PascalMALLE/ESP32-C3-IoT-Board/3DBoards view from DFM.png

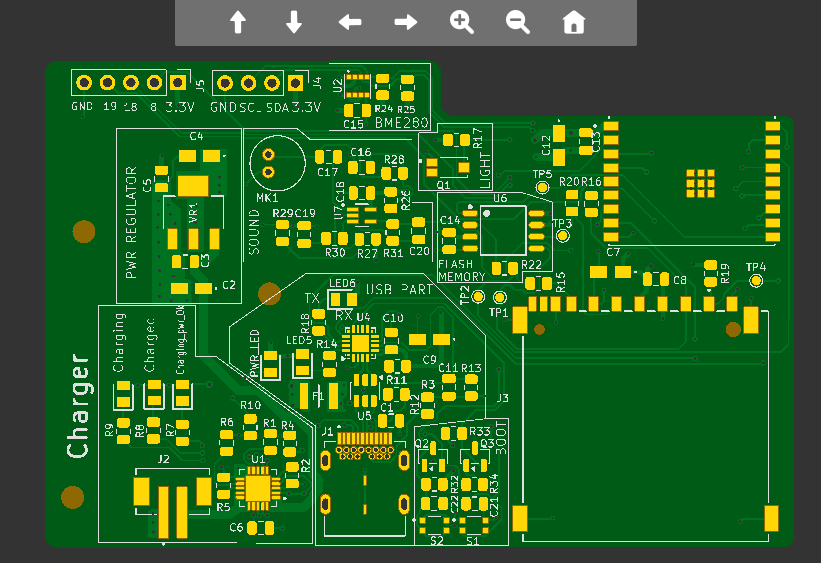
3DBoards view from DFM.png
