PascalMALLE/ESP32-C3-IoT-Board/3DBoards view from DFM_bottom.png

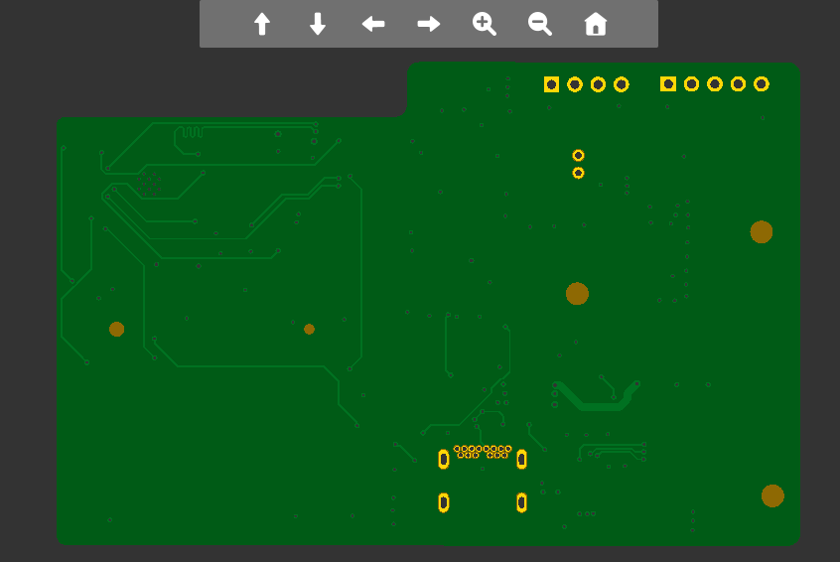
3DBoards view from DFM_bottom.png
