PascalMALLE/ESP32-C3-IoT-Board/3DViewDFM.png

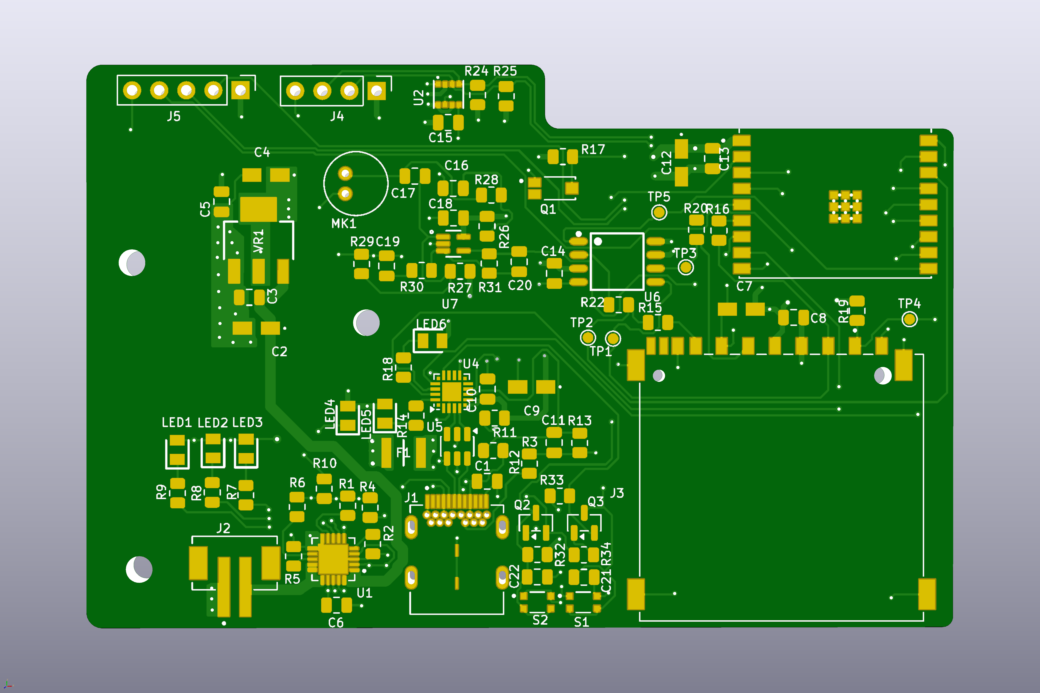
3DViewDFM.png
