PascalMALLE/ESP32-C3-IoT-Board/Front.png

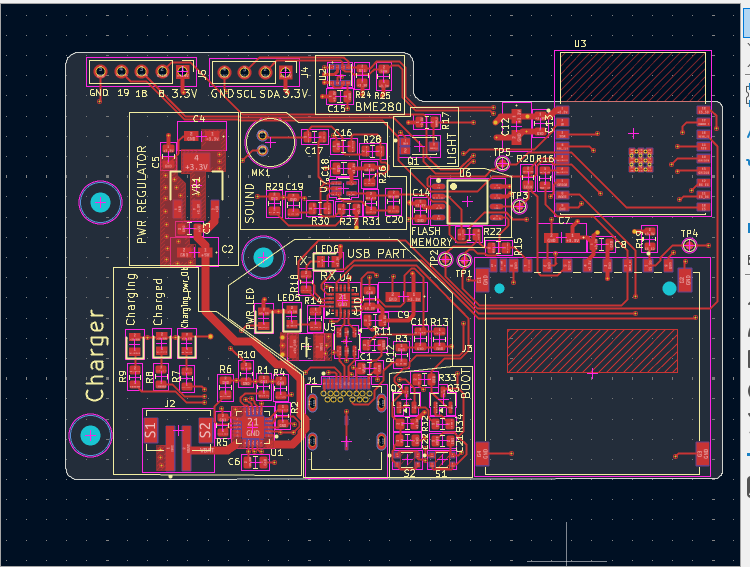
Front.png
