PascalMALLE/ESP32-C3-IoT-Board/TopDFM.png

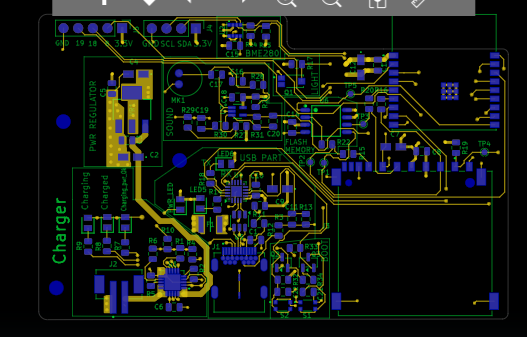
TopDFM.png
