PascalMALLE/ESP32-C3-IoT-Board/ESP32 Board Design_NextPCB.xlsx

Designator* | Quantity* | Manufacturer Part Number* | Manufacturer | Package/Footprint | Description | Procurement Type | Customer Note
C1,C3,C5,C8,C10,C13-C16,C18,C20,C21 | 12 |  |  | Capacitor_SMD:C_0805_2012Metric
C2,C4,C7,C12 | 4 |  |  | ESP32 Project Footprints:T491A
C6,C11,C19,C22 | 4 |  |  | Capacitor_SMD:C_0805_2012Metric
C9 | 1 |  |  | ESP32 Project Footprints:T491A
C17 | 1 |  |  | Capacitor_SMD:C_0805_2012Metric
F1 | 1 |  |  | ESP32 Project Footprints:FUSC3226X100N
J1 | 1 |  |  | ESP32 Project Footprints:BELFUSE_SS-52400-002
J2 | 1 |  |  | ESP32 Project Footprints:JST_B2B-PH-SM4-TB
J3 | 1 |  |  | ESP32 Project Footprints:AMPHENOL_GSD090012SEU
J4 | 1 |  |  | Connector_PinHeader_2.54mm:PinHeader_1x04_P2.54mm_Vertical
J5 | 1 |  |  | Connector_PinHeader_2.54mm:PinHeader_1x05_P2.54mm_Vertical
LED1,LED4,LED6 | 3 |  |  | ESP32 Project Footprints:LEDC2012X120N
LED2,LED5 | 2 |  |  | ESP32 Project Footprints:LEDC2012X120N
LED3 | 1 |  |  | ESP32 Project Footprints:LEDC2012X120N
MK1 | 1 |  |  | ESP32 Project Footprints:CUI_CMC-5042PF-AC
Q1 | 1 |  |  | ESP32 Project Footprints:TRANS_TEMT6000X01
Q2,Q3 | 2 |  |  | Package_TO_SOT_SMD:SOT-23
R1,R2,R17,R19,R30,R32-R34 | 8 |  |  | Resistor_SMD:R_0805_2012Metric
R3,R4 | 2 |  |  | Resistor_SMD:R_0805_2012Metric
R5,R26,R28 | 3 |  |  | Resistor_SMD:R_0805_2012Metric
R6 | 1 |  |  | Resistor_SMD:R_0805_2012Metric
R7-R10,R14,R18 | 6 |  |  | Resistor_SMD:R_0805_2012Metric
R11 | 1 |  |  | Resistor_SMD:R_0805_2012Metric
R12 | 1 |  |  | Resistor_SMD:R_0805_2012Metric
R13 | 1 |  |  | Resistor_SMD:R_0805_2012Metric
R15,R16,R20,R22 | 4 |  |  | Resistor_SMD:R_0805_2012Metric
R24,R25 | 2 |  |  | Resistor_SMD:R_0805_2012Metric
R27,R29 | 2 |  |  | Resistor_SMD:R_0805_2012Metric
R31 | 1 |  |  | Resistor_SMD:R_0805_2012Metric
S1 | 1 |  |  | ESP32 Project Footprints:SW_USLPT2819DT2TR
S2 | 1 |  |  | ESP32 Project Footprints:SW_USLPT2819DT2TR
TP1 | 1 |  |  | TestPoint:TestPoint_Pad_D1.0mm
TP2 | 1 |  |  | TestPoint:TestPoint_Pad_D1.0mm
TP3 | 1 |  |  | TestPoint:TestPoint_Pad_D1.0mm
TP4 | 1 |  |  | TestPoint:TestPoint_Pad_D1.0mm
TP5 | 1 |  |  | TestPoint:TestPoint_Pad_D1.0mm
U1 | 1 |  |  | ESP32 Project Footprints:QFN50P400X400X100-21N
U2 | 1 |  |  | ESP32 Project Footprints:PSON65P250X250X100-8N
U3 | 1 |  |  | ESP32 Project Footprints:MODULE_ESP32-C3-WROOM-02-H4
U4 | 1 |  |  | Package_DFN_QFN:SiliconLabs_QFN-20-1EP_3x3mm_P0.5mm_EP1.8x1.8mm
U5 | 1 |  |  | Package_TO_SOT_SMD:SOT-23-6
U6 | 1 |  |  | ESP32 Project Footprints:SOIC127P790X216-8N
U7 | 1 |  |  | ESP32 Project Footprints:SOT65P210X110-5N
VR1 | 1 |  |  | ESP32 Project Footprints:VREG_LM1117MPX-3.3
